htfab/pmod-factory/README.md

# Tiny Tapeout Factory Test PMOD

A PCB with buttons and leds to quickly test input, output and bidirectional pins on a Tiny Tapeout demo board.

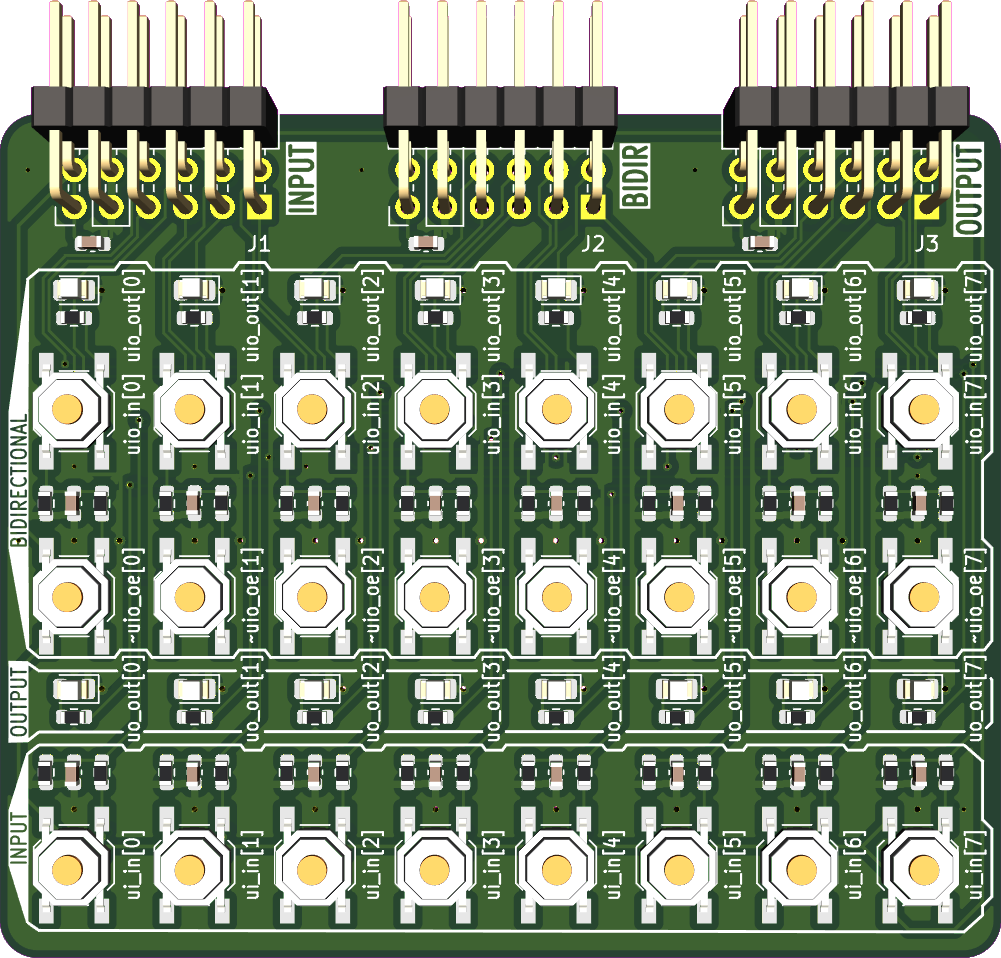
[picture p1: release/img/pmod-factory-front-asm.png]
Front side render


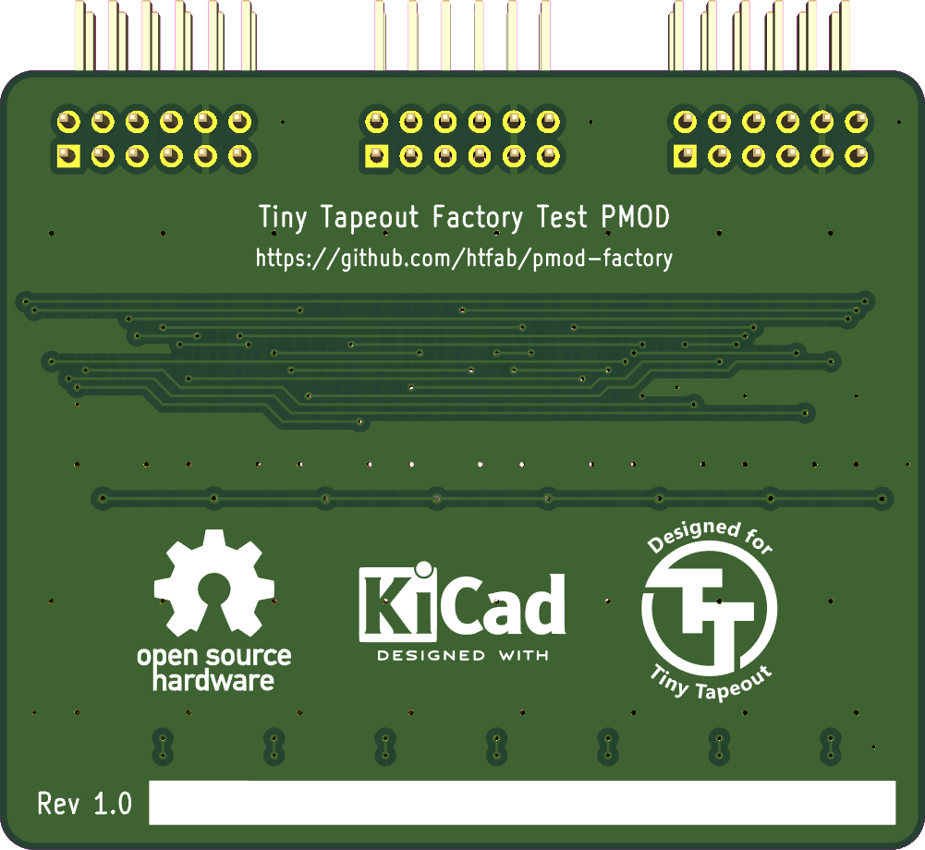
[picture p2: release/img/pmod-factory-back-asm.png]
Back side render


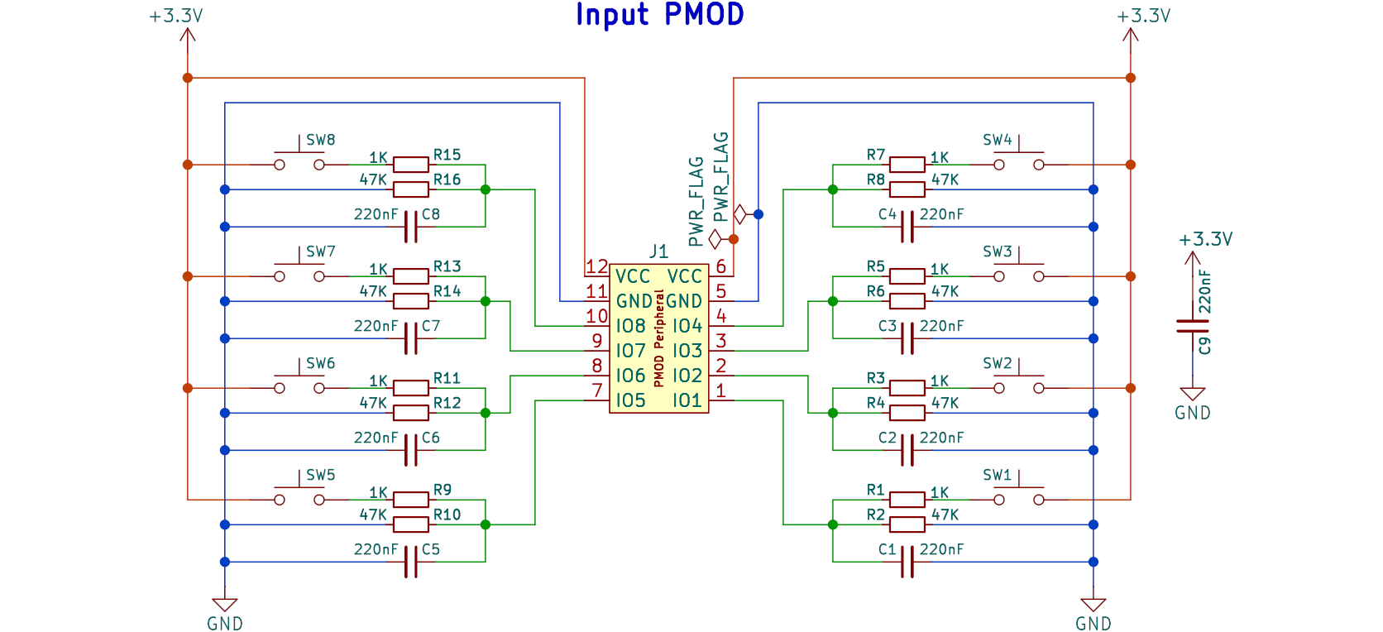
[picture p3: release/img/schem-input.png]
Input PMOD schematics


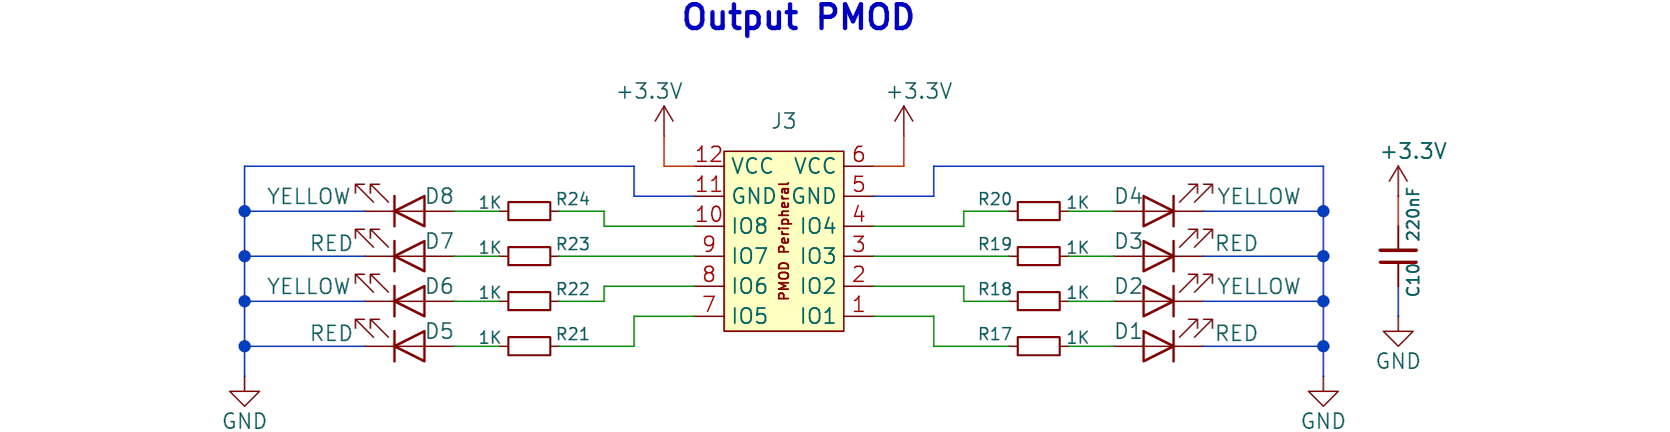
[picture p4: release/img/schem-output.png]
Output PMOD schematics


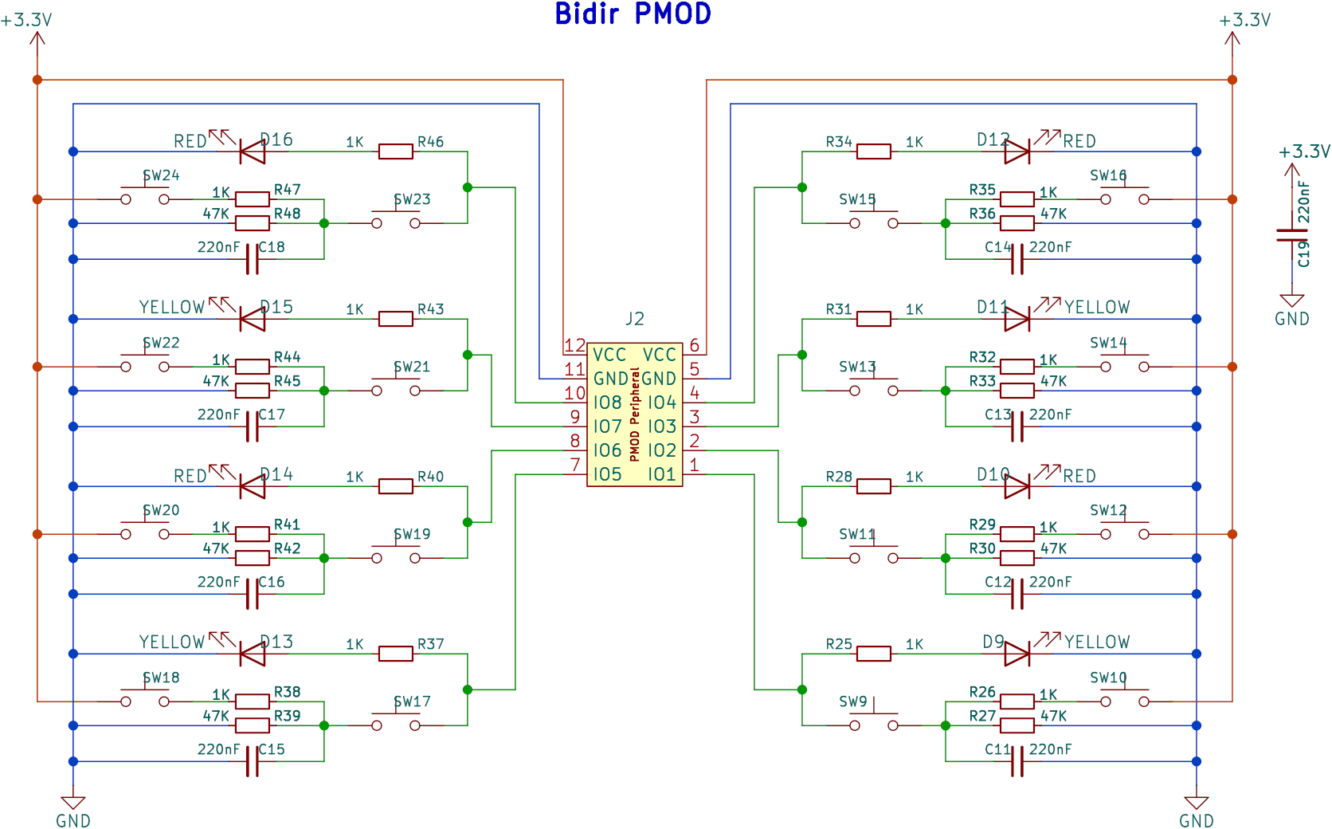
[picture p5: release/img/schem-bidir.png]
Bidir PMOD schematics
