htfab/pmod-factory/release/img/pmod-factory-back-pcb.png

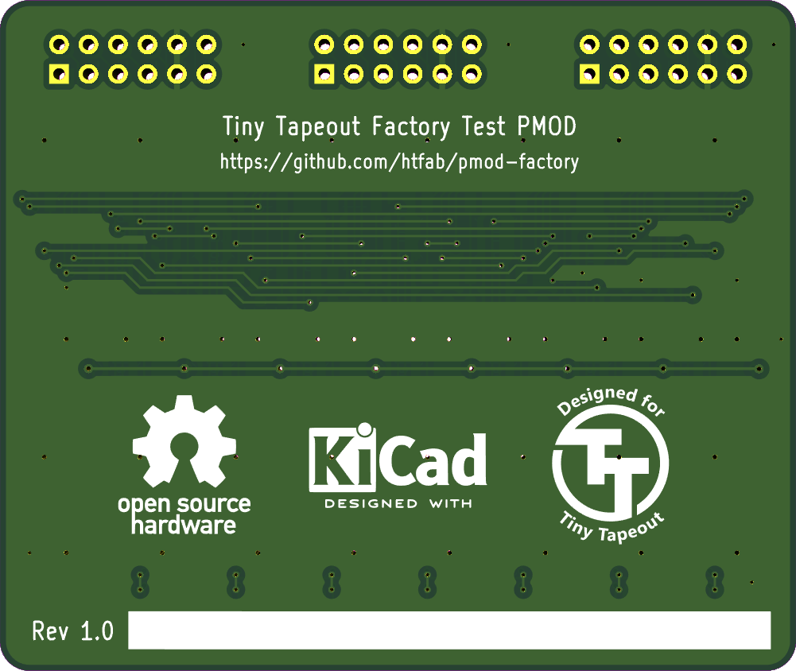
release/img/pmod-factory-back-pcb.png
