htfab/pmod-factory/release/img/pmod-factory-front-pcb.png

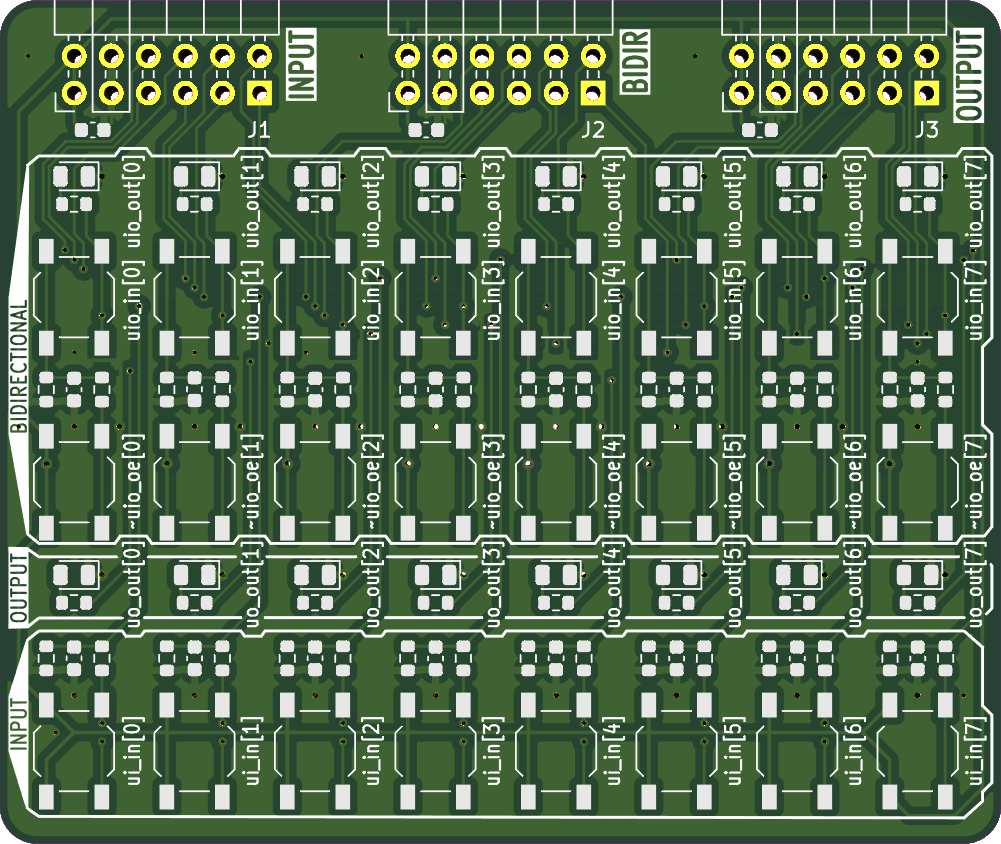
release/img/pmod-factory-front-pcb.png
