htfab/pmod-factory/release/pmod-factory-schematics.pdf

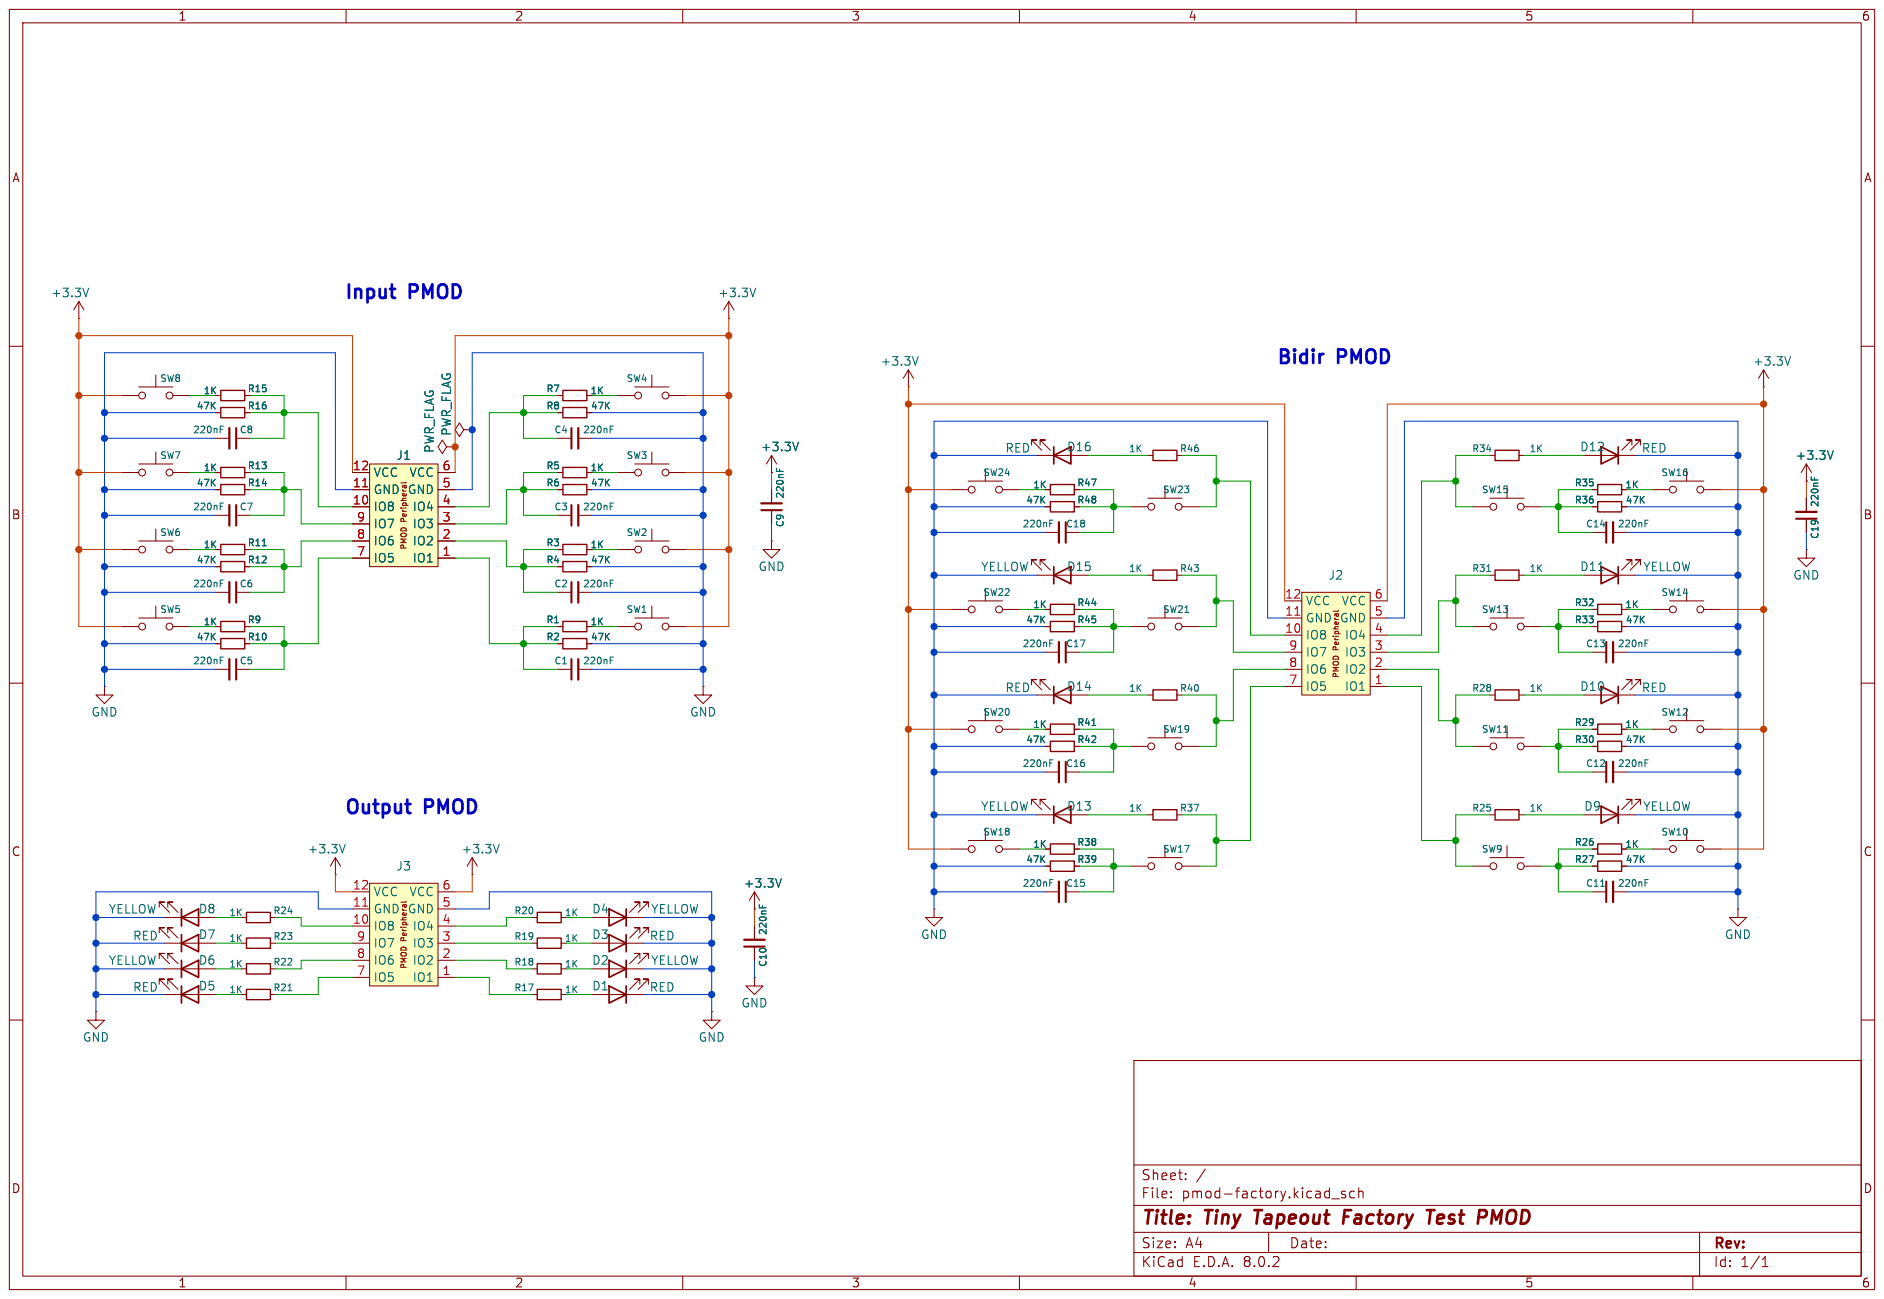
[picture p8: page 1]

File: pmod-factory.kicad_sch Sheet: / GND

Id: 1/1 Title: Tiny Tapeout Factory Test PMOD
