htfab/pmod-factory/(commit log)

2024-06-16 feat: add files to version control
    [pmod-factory.kicad_pcb, pmod-factory.kicad_sch]
2024-06-16 feat: remove dnp attributes
    [pmod-factory.kicad_pcb, pmod-factory.kicad_sch]
2024-06-16 feat: add generated files and readme
    [BOM-pmod-factory.csv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]
2024-06-16 feat: mark input, output & bidir sections on silkscreen
    [pmod-factory-CuBottom.gbr, pmod-factory-CuTop.gbr, pmod-factory-EdgeCuts.gbr, pmod-factory-MaskBottom.gbr, pmod-factory-MaskTop.gbr, pmod-factory-NPTH.drl, pmod-factory-PTH.drl, pmod-factory-PasteBottom.gbr]
